JoonatanAlanampa/stdcells/flow/offbin/devphys_offbin.png

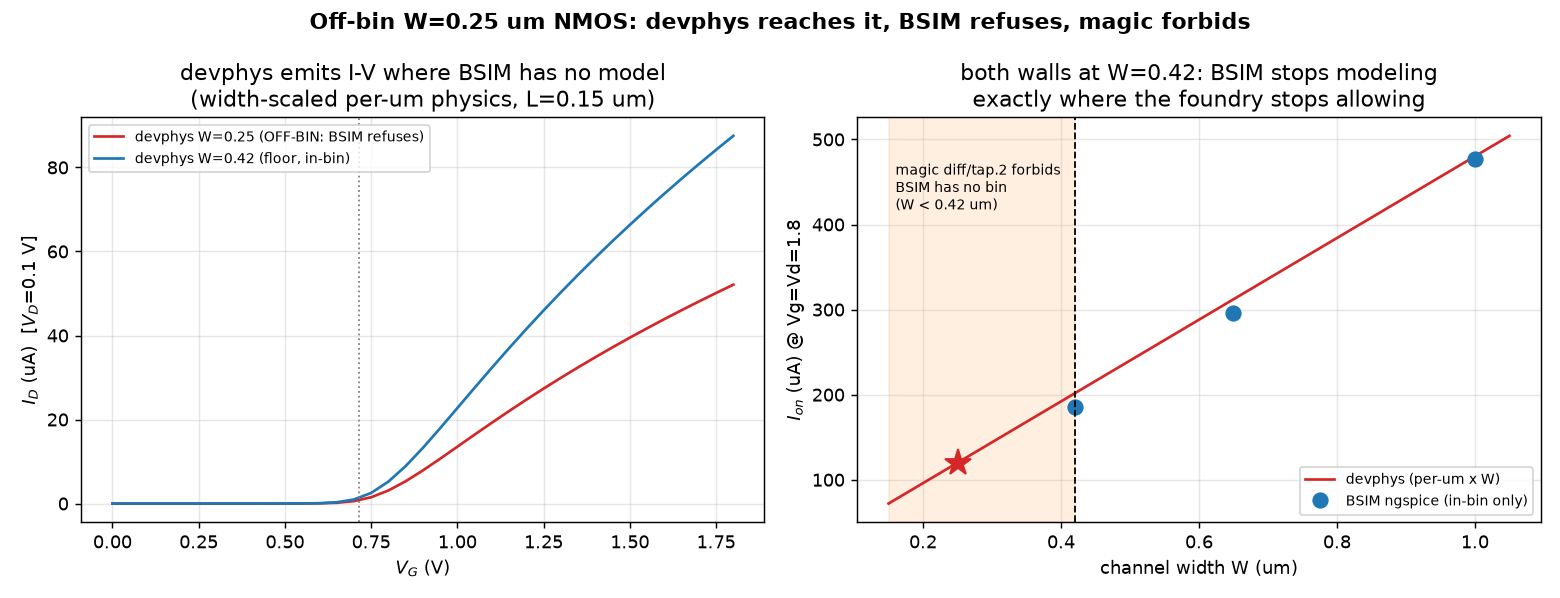
flow/offbin/devphys_offbin.png
