JoonatanAlanampa/stdcells/flow/v3/crosscheck_devices.png

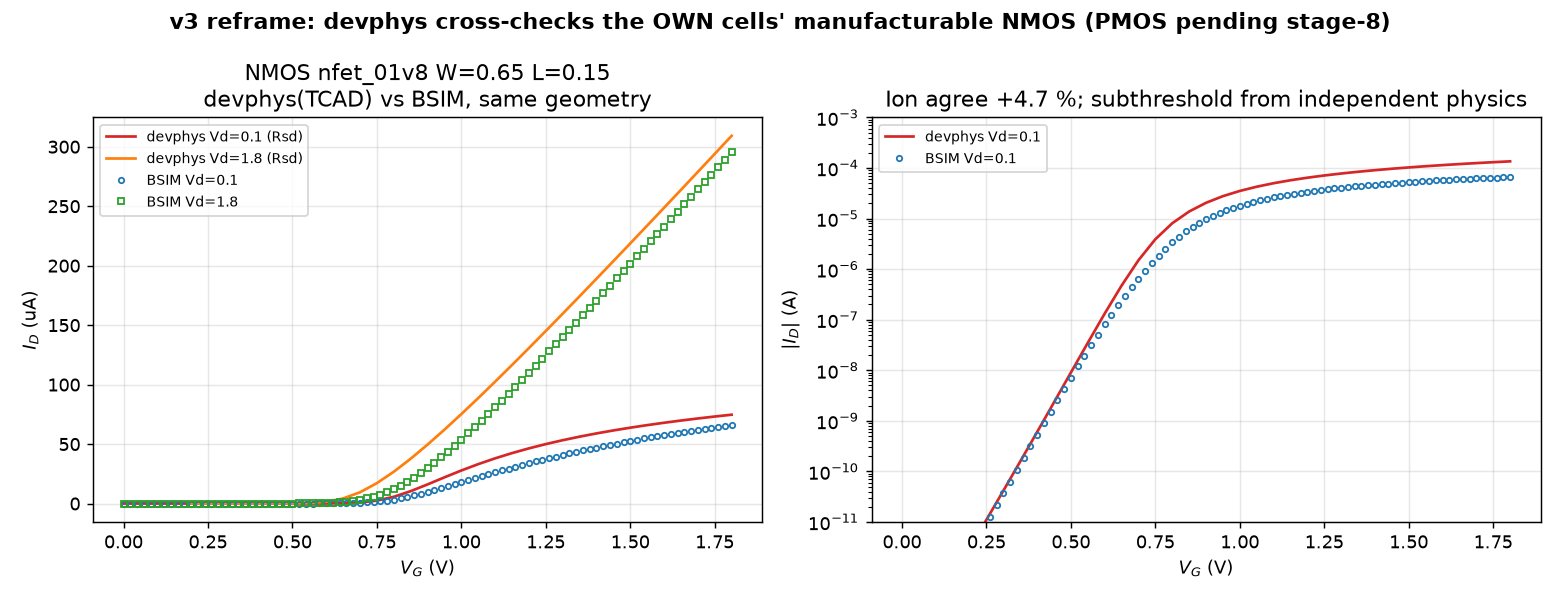
flow/v3/crosscheck_devices.png
