JoonatanAlanampa/stdcells/flow/offbin/nfet_w250_ref.spice

* reference: single nfet_01v8, W=0.25um L=0.15um
.subckt nfet_w250
X0 D G S VSUBS sky130_fd_pr__nfet_01v8 w=0.25 l=0.15
.ends
