JoonatanAlanampa/stdcells/(commit log)

2026-07-20 Phases 1-4: own standard-cell library, characterized, vs sky130_fd_sc_hd
    Device-probe-driven sizing (Wp/Wn=2.61 measured, svt PMOS chosen), 10-cell
    transistor-level library, own ngspice characterizer (~175 runs -> NLDM
    Liberty own.lib: caps, 3x3 delay/transition tables, DFF clk-q + setup
    bisection, leakage), and the CORDIC-1 RTL mapped to both libraries in the
    same yosys+ABC flow. Result: own lib is fast/fat/leaky by design - 1796
    cells / 15446 um2 / 773 ps vs foundry 969 / 8139 / 3525 ps; both meet the
    tapeout 50 MHz. svt leakage cost measured at ~200x on PMOS-off states.
    Windows lessons: ngspice .lib paths need 8.3 short form (spaces break the
    parser even quoted); yosys stat -liberty print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
2026-07-20 own.spice W/L artifact + phase 5 started: INV_X1 DRC-clean
    out/own.spice: every transistor of every cell with explicit W/L (the
    human-readable sizing record; rules in out/sizing.json). Phase 5:
    flow/layout.py generates INV_X1 GDS (gdstk, sky130 hd frame, both devices
    folded 2 fingers) - DRC-CLEAN against the PDK sky130A_mr.drc KLayout deck
    (feol+beol+offgrid) on iteration 2 (25 -> 0). Design lesson: folded cells
    need 4 sites (input contact needs its own column; the 3-site attempt
    shorted A to Y on li) - matches hd inv_2 being 4 sites; area model to be
    corrected from real layouts. README: PPA comparison table now on the
    front page.
    Claud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
2026-07-20 Phase 5: INV family (X1/X2/X4) all DRC-clean, real areas recorded
    layout.py generalized to N-finger INV pattern (alternating S/D columns,
    one poly pad column). X2 and X4 passed the full sky130A_mr deck on their
    first generated run - the proven pattern scales. Real areas
    (out/areas_real.json): 5.00 / 7.51 / 12.51 um2 = 4/6/10 sites vs the
    projected 3/5/8 - the folded-cell +1..2 site correction, now measured.
    Remaining: BUF/NAND/NOR (poly-routing puzzles), DFF (boss fight), LVS,
    area regeneration into own.lib.
    Claude-Session: https://claude.ai/code/session_01JfQjZNh94DSGAc3Krz5Jb2
2026-07-20 Phase 5: NAND2_X1 DRC-clean (iteration 2) - the 904-instance workhorse
    The first multi-input routing puzzle solved, using all three routing
    resources deliberately: B on a poly strap+pad between its adjacent gates;
    A on flanking poly pads joined by a met1 bar (poly cannot cross poly);
    Y entirely on li (P-drain bar + N-drain low jog rising at the c3 column);
    the middle vdd tap escapes vertically on met1 so the Y li bar stays
    continuous. ndiff = two ABBA series chains with uncontacted internal
    nodes; pdiff = 4 parallel fingers. Round-1 fixes: met1 bar must enclose
    its mcons by 0.06 (m1.4 x4); N licon row dropped to y=0.52 so the jog li
    gets its 0.08 licon enclosure (li.5). Real area 8.76 um2 =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
2026-07-20 NOR2 DRC-clean + NAND2 LVS-safe pads + de-rated netlists re-characterized
    NAND2: B pad moved above the pdiff (the mid-band pad poly dipped 0.045um
    into ndiff - DRC-legal but a parasitic-gate LVS hazard); still DRC-clean.
    NOR2: mirrored NAND2 recipe (series chains on P, low Y bar, vss mid-tap
    escapes down on met1) - clean in 2 rounds (li.3 fix: c2 stub takes its
    licon enclosure on x-sides). Library economics in cells.py: NOR2 pull-up
    de-rate (no stack comp - 3.4um series pfets unbuildable in-row), NAND3
    stack comp capped at 2x, NOR3 DROPPED (5.1um pull-up for 11 instances).
    Re-characterized (measured de-rate costs: NAND3 tp 146->191ps; NOR2 cin
    4.75->2.89fF) and re-compared with real areas fo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
2026-07-20 Phase 5: BUF_X2/X4 clean, NAND2 hidden short fixed, NAND3 dropped - all 7 combinational cells DRC-clean
    Found by review, not DRC: NAND2''s Y bar OVERLAPPED the c2 vdd escape li
    patch - same-layer different-net shorts MERGE silently in DRC and only
    LVS would catch them. Fix pattern: Y bars sit 0.17 BELOW the P-row li
    patches (bar at 1.325..1.495), escape patches licon-width with y-pair
    enclosure. BUF_X2/X4: A strap+pad at the c0 column, yb rises from the c1
    drain column to a top run, Y bar low; every vdd stub in a bar/run path
    becomes a met1 escape (computed per cell). NAND3: routing analysis
    proved its inner-solo input has NO legal join slot in this template (the
    li bar needs 0.17 clearance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
2026-07-20 Final 8-cell library numbers: 1783 cells / 17686 um2 (2.17x) / 913 ps
    Re-characterized (8 cells, real areas for all but DFF) and re-compared:
    NAND3 removal remapped its 259 uses into NAND2 (751) and NOR2 (580)
    chains; area ratio 2.17x, critical path 913 ps (still 3.9x faster than
    hd, 22x margin to the 50 MHz tapeout clock). README table updated with
    the library-economics note.
    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
2026-07-20 Phase 5b: ALL 7 cells LVS-clean - and LVS caught a real bug
    KLayout LVS flow (run_lvs_all.py) using the PDK sky130.lvs deck, with
    three hard-won adaptations: (1) reference netlists need M cards, not X
    (the deck reader flattens unknown X-subcircuits to nothing); (2) unit
    suffixes are mandatory (bare W=1.7 is SPICE meters -> 1.7e6 um, nothing
    pairs); (3) the deck is auto-patched with same_device_classes to bridge
    the reader uppercasing schematic device classes vs lowercase extraction.
    Substrate is exposed as a reference port (cells carry no taps).
    THE CATCH: BUF_X2/X4 layouts had DOUBLE-WIDTH nfets (1.3/2.6 vs netlist
    0.65/1.3) - the series-chain ndiff height was copy-pasted into a
    parallel-fi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
2026-07-20 Phase 5c: LEF abstracts + the DFF hybrid decision
    make_lef.py derives LEF from the LVS-verified GDS itself: pin ports =
    full connected li/met1 polygon under each label (max router access),
    rails as POWER/GROUND abutment pins, remaining li/met1 as OBS; site
    unithd; merged own_cells.gds emitted for the P&R flow.
    DFF verdict after analysis: transmission-gate flops need split-poly
    columns whose lower (ndiff-side) gate contact has no legal landing zone
    in this template - a structural dead-end, not an iteration problem.
    Hardening proceeds with a HYBRID library (own 7 combinational + foundry
    dfxtp_1), standard industry practice, clearly documented; fully custom
    DFF (wider template or met2) is the s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
2026-07-20 CI: pin librelane container to 3.0.5 (no latest tag published)
    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
2026-07-20 Phase 6 checkpoint: CI flow reaches detailed routing; pin-access lesson
    Seven iterations took the cloud flow from billing block to DRT: the
    pipeline (container, cached PDK, elaborate-only, floorplan, PDN,
    placement, CTS, global route) all works. Detailed routing fails with
    DRT-0073 on NAND2/NOR2 B pins: top-region pads live under the VPWR
    rail met1 shadow - no via window. Template analysis shows no escape at
    7 sites with 0.85um folded pdiff (mid-band poly contacts blocked by the
    0.19 pdiff-licon clearance; flanks unreachable through outer gates on
    poly; higher straps merge with the mirrored neighbor row). Root lesson:
    fat folded PMOS is incompatible with in-cell pin access - which is why
    the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
2026-07-21 V2 library: hd architecture, all 7 cells DRC+LVS clean in 2 iterations
    The phase-6 DRT-0073 post-mortem said fat folded PMOS closes the cell
    mid-band and starves input pins of access points. v2 rebuilds the
    library the way that lesson points: Wp=1.0/Wn=0.65 single-finger, no
    folding, no stack compensation - drive scaling by parallel fingers.
    - flow/cells.py: per-finger netlists (topologically identical to the
    layouts, so LVS needs zero overrides); projected site model now
    matches hd exactly (3/3/5/4/6/3/3 sites - v1 was 1.3-2.3x bigger).
    - flow/layout.py: full rewrite on the hd cell architecture (studied
    from the PDK GDS, Apache-2.0, re-implemented generatively): input
    pads hook off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
2026-07-21 CI signoff: official KLayout deck + hvtp corner healing; demote magic
    First v2 hardening run verdict: routing CLEAN (DRT-0073 dead), timing
    met at all corners (setup ws +3.46ns @ss, hold +0.11ns @ff), antenna
    clean - but the job failed in magic-based signoff. Investigation on the
    downloaded artifacts:
    - The KLayout-streamed GDS had EMPTY custom cells (EXTRA_GDS_FILES not
    merged) - any check on it is void. The magic-streamed GDS is correct
    (layer-identical to our originals).
    - Official KLayout mr deck on the TRUE GDS: 144 violations, ALL hvtp
    implant width/spacing at 36 corner-pinch sites - hd's hvtp band
    ending at x in one row and starting at the same x in the mirrored
    row, touchi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
2026-07-21 1x1 experiment: pin the die to the TinyTapeout 1x1 tile (161 x 111.52)
    Absolute floorplan at the exact tile the fabricated CORDIC-1 used
    (921 hd cells @ 74% util). Logic area says ~75% utilization for the
    v2 library - borderline by design; this run answers it.
    Claude-Session: https://claude.ai/code/session_01BBgRsC21eUfRQYrmY8tttg
2026-07-21 Custom DFF_X1: dfxtp_1 geometry re-targeted to svt, DRC+LVS clean
    The flop completes the v2 method (hd architecture, re-verified through
    our own pipeline): flow/make_dff.py takes the proven dfxtp_1 polygons,
    DROPS the hvtp layer - which converts every pfet to the svt flavor
    this library is built on - renames to DFF_X1 on our layer conventions,
    and the result goes through the same signoff as every other cell:
    - official-deck DRC: CLEAN (first run)
    - LVS: MATCH against the transcribed 24T netlist in cells.py (dfxtp
    topology: TG inputs, clocked-inverter feedback, local clock buffer;
    the four pass nfets are the PDK 'special' flavor, which the LVS
    deck normalizes to nfet_01v8 - reference d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
2026-07-21 Magic-native: areaid.standardc on every cell + foundry-control criterion
    Magic diagnosis (first magic.yml run) found exactly four rule
    categories on our cells: licon.11 (contact-to-gate 0.055) plus
    nwell.4/LU.2/LU.3 (tap and latch-up connectivity). The tell: DFF_X1 -
    verbatim hd geometry - does NOT fire licon.11: hd cells carry the
    areaid.standardc (81/4) marker, which relaxes magic's contact-to-gate
    check to the 0.05 the cells actually use. Our generated cells never
    drew it. Added to the frame; KLayout decks define but never use the
    layer (verified), so the existing signoff is untouched - re-ran DRC
    and LVS on all 8 cells: still clean.
    The remaining categories are cell-level-only artifacts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
2026-07-21 CI magic: print violation boxes (locating the BUF_X2 licon.11)
    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
2026-07-21 BUF_X2: stage-2 drain licons to x 1.155 - magic caught a real 45nm gap
    The licons sat at the 1.15 column center; the legal spot is midway
    between the gate EDGES (1.02..1.29 -> 1.155). At 1.15 the contact-to-
    gate gap is 0.045 < 0.05 (licon.11) - flagged by magic's standard-cell
    rule, missed by the klayout deck's formulation. The magic-views
    workflow just paid for itself. DRC+LVS re-verified clean.
    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
2026-07-21 BUF_X1: the hold-fix cell - 9th cell, all signoff clean
    DFF_X1's 150ps-faster clk-q tripled hold repair (296-315 BUF_X2s,
    ~1.5k um2) and sank the all-own 1x1 floorplan twice. OpenROAD's
    RepairHold::findHoldBuffer picks the buffer maximizing hold-delay/
    area; BUF_X1 (one finger per stage, 213 ps mid vs BUF_X2's 171 in
    the same 4-site footprint, and relatively slower still at hold-chain
    loads) wins that metric, shrinking the repair bill.
    Layout: buf_x2's stage-1 recipe + single stage-2 finger. Two DRC
    iterations: the Y bar's mid-band neck needs >= 0.17 x-overlap with
    its bars (li.1 throat) while clearing the yb pad patch corners at
    0.197 euclidean. All 9 cells DRC clean + LVS MATCH; character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
2026-07-21 1x1 attempt 4: reclaim the core margins (default 4/4/12/12 mults ate 21.8um of die height + 11um of width = 25% of the tile). At 1/1/2/2 the core grows 13.5k -> 16.9k um2, dwarfing the ~1.5k hold-buf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
    (BUF_X1 stays in the library: RSZ evaluates hold buffers at light
    load where its weak stage has no delay advantage - the delay/area
    metric tied with BUF_X2 and the pick did not change. Lesson noted.)
    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
2026-07-21 README polish: 9-cell contact sheet (DFF_X1 + BUF_X1 included), de-stale
    - contact sheet: all 9 cells in 3 rows, DFF_X1's full 24T layout shown
    - PPA table: real-DFF numbers (9821 um2, 1.21x), all areas from signoff
    - chain: step 6 all-own netlist, new step 7 magic-native views
    - removed the obsolete hybrid-decision paragraph (one-line history note)
    - 'magic views are future work' -> done, cross-referenced
    - disclosure: flow-inserted foundry cells (~7k um2) + identified next leg
    - status/requirements brought current
    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
2026-07-21 Zero-foundry leg: 7 physical cells + all flow roles moved to own cells
    New cells (all official-deck DRC clean; TIE also LVS MATCH):
    - TIE_X1: cross-coupled 2T tie (no poly-resistor trick, no waiver
    labels) - replaces conb_1; hilomap now targets it. Routing: HI band
    above the pad level, LO band below it, shared source column escapes
    on met1.
    - WELLTAP_X1 (1 site, inverted implants), DIODE_X1 (antenna, with
    LEF ANTENNADIFFAREA), FILL_X1/2/4/8.
    - make_lef: proper LEF classes (WELLTAP/ANTENNACELL/SPACER), HI/LO
    as outputs; make_hardening appends physical-cell liberty blocks to
    own_hardening.lib (abc still sees the comb-only lib).
    - config: FP_WELLTAP_CELL/FP_ENDCAP_CELL/FILL_CELL/DEC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
2026-07-21 Fix magic licon.8 on BUF_X1 + add max_transition to liberty outputs
    - BUF_X1's yb pad poly hook extends to x=1.055: magic's licon.8 wants
    0.05 poly enclosure and the right side had 0.045 (second real 5nm
    bug magic caught that the klayout deck formulation passes; BUF_X1
    joined the magic list only this week). DRC+LVS re-verified.
    - CTS-0107: TritonCTS requires max slew on clock buffer outputs - our
    liberty had max_capacitance only. characterize.py now emits
    max_transition (= top of the measured slew table); own.lib patched
    in place to avoid a 90-minute re-characterization for one attribute.
    Claude-Session: https://claude.ai/co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
2026-07-21 TIE pin markers inside the patches (magic merges pin datatype into li) + explicit CTS characterization ranges (CTS-0065)
    Magic reads lipin (67/16) as li and merged our default-y markers 0.03
    above TIE_X1's short pad patches -> phantom 0.14um gap to the HI band.
    Markers now at y=1.16, fully inside the drawn li. KLayout deck never
    sees pin datatypes - another checker-complementarity find.
    CTS-0065 (normalized LUT values out of [1,1023]): constrain the
    TritonCTS characterization to CTS_MAX_SLEW 0.75ns / CTS_MAX_CAP 50fF.
    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
2026-07-21 Liberty load-axis unit bug: tables were fF against a declared pF unit
    capacitive_load_unit is (1, pf) but index_2 was emitted in
    femtofarads ("5.0, 25.0, 100.0") - STA read every table as if
    characterized at 5-100 pF and extrapolated below the first index for
    all real loads. TritonCTS was the first tool to refuse (CTS-0065,
    normalized slews out of range); OpenSTA/ABC silently produced
    optimistic fiction instead.
    - characterize.py emits the axis in pF; own.lib corrected in place
    (45 tables - the measured VALUES were always at 5/25/100 fF, only
    the labels change).
    - Honest PPA after the fix: ABC path 1890 ps vs hd 3525 (0.54x, was
    claimed 0.26x); area 9106 um2 (1.12x). README corrected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
2026-07-21 TIE_X1 abutment + via-farm fixes (all 74 zero-foundry DRC violations)
    Every violation sat at a TIE_X1|BUF_X2 boundary (each tie output feeds
    an inserted buffer placed flush against it):
    - difftap 0.26: TIE pdiff margin was 0.125; abutment math needs 0.135
    each side for the 0.27 rule. Pfet column shifted (gate 0.91, drain
    1.12, diff to 1.245) keeping both 0.05 contact-gate gaps.
    - li 0.165: LO patch margin 0.08 -> 0.095.
    - li 0.16 via farms: the router dropped via pairs on adjacent tracks
    of the wide HI/LO pin bands; make_lef now clips TIE pin ports to
    the pad-patch band (exactly one met1 track), rest becomes OBS.
    DRC clean, LVS MATCH, LEF regenerated.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
2026-07-21 LEF: clip all signal pin ports to y 0.48-2.24 (rail-zone via exclusion)
    The 38 residual zero-foundry li.3 violations were pin-access vias
    landed on the rail-adjacent thirds of tall pin shapes, 0.12-0.16 from
    neighbor rows' power stubs across the row boundary - legal to DRT's
    abstraction, rejected by the signoff deck. Ports now exclude those
    zones (excluded metal becomes OBS); every pin was designed mid-band
    reachable so no access is lost. Multi-piece clip results emitted in
    full.
    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
2026-07-21 LEF: one met1 track per pin (pad row) - same-net via pairs eliminated
    The mutated 38 li.3 were same-net pin-access via PAIRS 0.16 apart:
    DRT has no same-net li spacing in its model, the manufacturing deck
    has no such exemption. With every port clipped to the single pad-row
    track (fallback to the wide band only if a pin has no mid-band metal),
    no pin can host two vias. Excluded metal stays as OBS.
    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
2026-07-21 LEF: label-window ports (one via site per pin, deterministic)
    The single-track y-clip still allowed via pairs ALONG long pin bars
    (x-adjacent, 0.33 apart), and DRT ground for 3h - both symptoms of
    port freedom the deck cannot accept. Ports are now a 0.5um window
    around each pin label on the pad row (fallbacks widen only if a label
    has no metal there): exactly one via site per pin, every window at a
    by-design clean spot. Replaces the TIE special case.
    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
2026-07-21 Architectural fix: all signal pins move to MET1 pads
    Three rounds of li.3 whack-a-mole (via pairs, via-vs-stub, 3h DRT
    thrash under port restriction) had one root: the router accessing li
    pins creates li geometry the manufacturing deck rejects, and DRT's
    model disagrees with the deck on li specifics. Standard modern-library
    answer applied: every cell carries an in-cell mcon + met1 pad per
    signal pin (labels moved to met1) - the router now connects at met1
    and NEVER draws or lands on li.
    - pin() emits mcon + 0.28x0.30 met1 pad (min-area; 0.42-spaced pins
    keep m1.2), x clamped 0.245 from edges (abutted pads >= 0.21 apart),
    y clamped so pads keep 0.14 to the rails; post-generation assertio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
2026-07-22 lib-v1.1: multi-PVT characterization (tt/ss/ff signoff corners)
    Characterize the full 9-cell library at all three sky130A signoff corners
    (tt_025C_1v80, ss_100C_1v60, ff_n40C_1v95) so the timing views actually
    differ. Before this, the single-PVT own.lib went in via EXTRA_LIBS, which
    LibreLane loads for every corner -> all nine STA/SDF corners came out
    byte-identical, so a measured-vs-predicted ring-oscillator gap in silicon
    had no corner spread to be attributed to.
    - flow/characterize.py: loop over PVT corners -> per-corner own_<corner>.lib
    + nominal own.lib. DFF captures are each preconditioned into the opposite
    state so clk->Q no longer depends on the flop's power-up value (which went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
2026-07-22 README: PVT analysis section — custom library vs sky130_fd_sc_hd
    Add flow/pvt_compare.py (stdlib-only Liberty parser + bilinear interpolation
    to a common operating point, slew 0.30 ns / load 0.025 pF) and a README
    section comparing the custom lib-v1.1 cells against the foundry hd library
    across tt/ss/ff: delay, corner spread (ss/ff), leakage, and area.
    Findings: custom svt cells are faster than hd at tt/ss for every cell (DFF
    CLK->Q ~1.9x faster at the timing-critical ss corner) with a tighter delay
    band at this op-point; leakier by design at tt (DFF ~126x). Leakage is
    explicitly caveated as a single-state, single-point lower bound -- the
    apparent own<hd at ss is the measurement gap, not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
2026-07-22 lib-v1.2: internal_power, per-state leakage, RO-interior NLDM grid
    Characterization additions (research/internal-power.md), all measured:
    - Grid 3x3 -> 4x4: prepend a fast-slew (20 ps) and low-load (2 fF) point so the
    ring-oscillator operating point (~50 ps, ~3.6 fF) is INTERIOR to the NLDM box.
    At lib-v1.1's LOADS[0]=5 fF the RO load fell below the grid and OpenSTA
    extrapolated the ring-stage delay -- the one gap that moves the silicon
    prediction. Nominal delays at the shared grid points are unchanged, so the
    hardened netlist (harden/cordic_gates.v) is byte-identical to lib-v1.1.
    - internal_power (rise_power/fall_power, pJ) for the 8 combinational cells,
    folded into the existing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
2026-07-22 v3: scaffold the devphys-custom-geometry leg (plan + model-bin checker)
    Start the v3 library leg — custom transistor geometries characterized by
    devphys where stock BSIM stops. Phase 0 (device-validity) deliverables:
    - V3-PLAN.md: phased plan. Scope (a) rectangular custom geometries [main path],
    (b) annular/ring-gate = gated spike. The real wall is MODEL VALIDITY, and the
    mapped finding is that stock BSIM already TILES the whole rectangular envelope
    (L 0.15..100, W 0.36..100 um; 0 interior gaps across all 4 core flavors), so
    devphys is only strictly necessary in the "devphys zone" W in [0.15, 0.36) um
    (DRC-legal, but no BSIM bin -- continuous or special_). Phase-1 proof device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
2026-07-22 v3 scope-b: annular (ring-gate) nfet magic-extract gate-check
    Add flow/annular/ — a DRC-clean hand-drawn annular nfet (enclosed drain,
    poly-ring gate L=0.15 um, ring source, gate contact routed out over a field
    notch so it never crosses source diff) — plus a magic-extract CI job
    (annular.yml, reusing the librelane container from magic.yml) that answers the
    v3 scope-b question the research flagged (custom-devices.md Q2): does magic
    extract a closed-loop gate as an nfet, with what W, and pass magic's DRC?
    KLayout manufacturing-deck DRC is already 0 (research/annular_gate/). Additive;
    touches no library/harden files.
    Cla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
2026-07-22 v3 scope-b: annular gate-check RESULT — DRC dead-end (poly.11)
    magic-extract CI verdict: magic EXTRACTS the ring gate as a valid nfet
    (sky130_fd_pr__nfet_01v8, W=1.75um L=0.15um, D/G/S/sub correct) — refuting the
    "mis-extracts / no defined W" fear — BUT magic DRC forbids it: 30 violations
    headed by `poly.11: No bends in transistors`. KLayout manufacturing deck passed
    the same layout (0), confirming KLayout-clean != rule-clean. Annular is not a
    viable v3 device.
    Claude-Session: https://claude.ai/code/session_01RUL8LjRicFwRfPE7fobeb6
2026-07-22 lib-v1.3: NLDM load-monotonicity guard + honest early-trip documentation
    flow/check_monotonic.py asserts (fast CI gate, no PDK/P&R) that delay is
    monotonic in OUTPUT LOAD across every corner -- physically unconditional and the
    property STA leans on for a fixed driver. Holds today with 0 exceptions.
    It deliberately does NOT require slew-monotonicity. These cells are asymmetric by
    design (WP 1.0 > WN 0.65 um, the routability sizing), so the switching threshold
    sits off Vdd/2 and the 50-50 propagation delay legitimately goes negative and
    shrinks with a slower input ramp -- the output trips before the input reaches
    50 %. Waveform-confirmed: INV_X4 cell_fall at ff/1.5 ns/2 fF crosses output-50 %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
2026-07-23 v3: off-bin rectangular nfet gate-check (draw + KLayout DRC local + magic/LVS CI)
    The pinned v3 "devphys where BSIM stops" proof device (W~0.25um NMOS) tested
    against the real transistor-width rule. Draws a dogbone W=0.25um device (OFF-BIN,
    sub-0.42) and a W=0.42um in-bin control; both pass the KLayout manufacturing
    deck clean (no transistor-width rule there). The magic CI (offbin.yml, mirrors
    annular.yml) adjudicates diff/tap.2 "Transistor width < 0.42um" + netgen LVS.
    Finding (from the decks; CI confirms empirically): a rectangular gated transistor
    at W<0.42um (0.36 special) is magic-DRC-forbidden by diff/tap.2 -- KLayout is
    blind to it. The BSIM model floor coincides with the magic trans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
2026-07-23 v3 offbin: RESULT — off-bin rectangular device CLOSED (diff/tap.2 = BSIM floor)
    The pinned off-bin W=0.25um NMOS is a dead-end, same class as annular. magic
    diff/tap.2 "Transistor width < 0.42um" forbids it (CI green: W=0.25 flags it,
    W=0.42 clean; both extract + netgen-LVS-match as nfet_01v8); BSIM ngspice refuses
    it ("could not find a valid modelname"); Phase-0 showed no narrow-W silicon
    effect. Three coinciding walls -> all three exotic "devphys where BSIM stops"
    targets now closed.
    - model_bins.py CORRECTED: the "devphys zone [0.15,0.36)" was an artifact of the
    plain-diff floor (difftap.1=0.15). The gated-FET floor is magic diff/tap.2
    (0.42 std / 0.36 special_), which COINCIDES wi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
2026-07-24 v3 Phase 2: devphys cross-check of the OWN cells + CORDIC-1 re-harden
    Phase 2 delivered on the reframe footing (devphys = independent from-physics
    cross-check of the manufacturable rectangular cells), NOT as an hvt cell set.
    1. longL_gate.py — the suggested vehicle is a 4th dead-end: a longer-L
    "geometric-hvt" NMOS gives NO leakage win on sky130 (halo/RSCE lowers Vt as
    fast as longer L suppresses DIBL -> Ioff flat at 25C, Ion/Ioff only worsens;
    best hot-corner step x1.09). Stacking IS a real lever (3.5x Ioff @100C) but
    hot-corner-only and already used in NAND2/NOR2.
    2. crosscheck_devices.py — devphys stages 4c/4d (TCAD, silicon-calibrated,
    L=0.15) vs BSIM on the library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
2026-08-05 lib-v1.5: M15 + M16 — two attributes OpenSTA was never able to read
    Neither defect was a wrong number. In both cases the measured data was
    correct and present in the file, addressed so that the consuming tool never
    looked at it — and every downstream check therefore reported a comfortable
    constant. Re-characterizing all three corners changes exactly TWO LINES per
    liberty and not one measured value, which is the claim, verified.
    M15 — the library declared no fanout load at all. OpenSTA computes a net's
    fanout by summing `fanout_load` over its sinks, falling back to the library's
    `default_fanout_load`. This library emitted neither, so every net in every
    design summed to 0.0, `set_max_fa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
